17179869184/Mapa-zastavek-salin/schemata/ceska.png

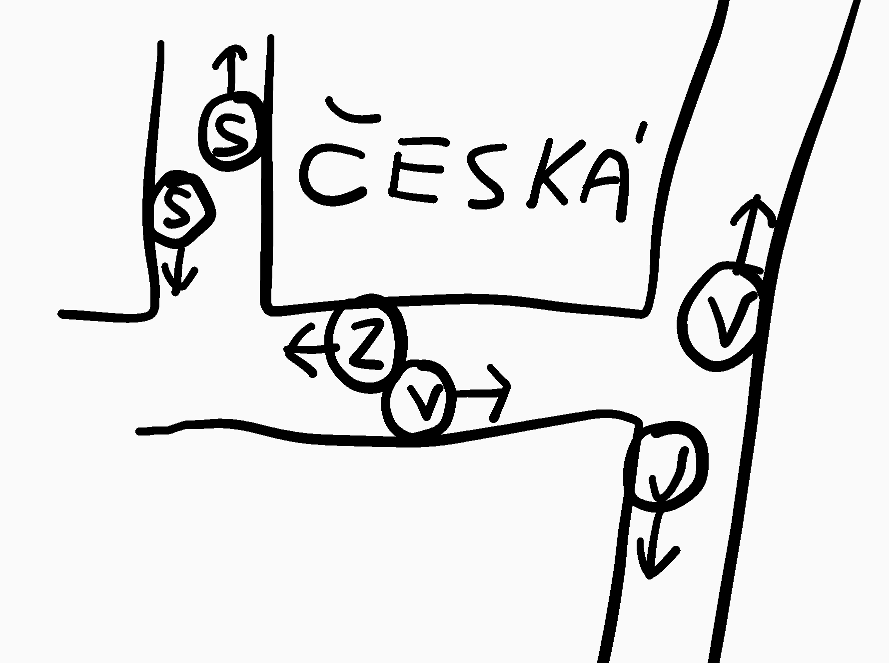
schemata/ceska.png
