17179869184/Mapa-zastavek-salin/schemata/hlavninadrazi.png

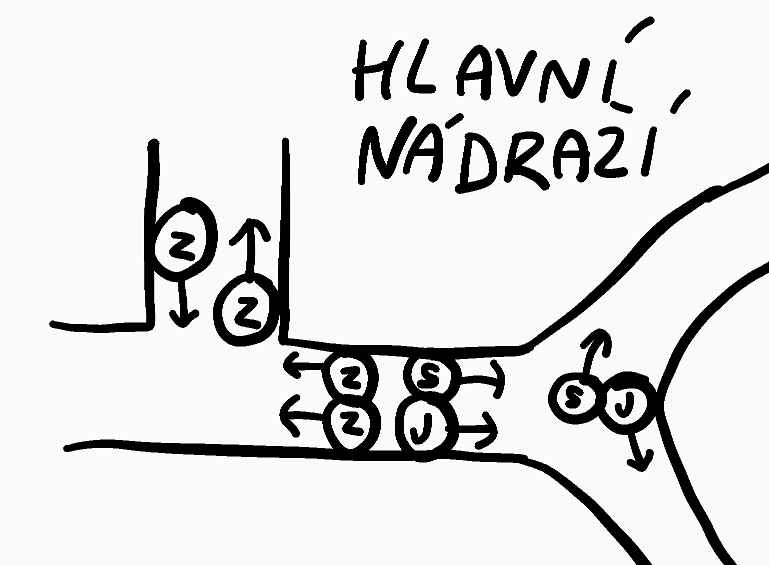
schemata/hlavninadrazi.png
