17179869184/Mapa-zastavek-salin/schemata/jugoslavska.png

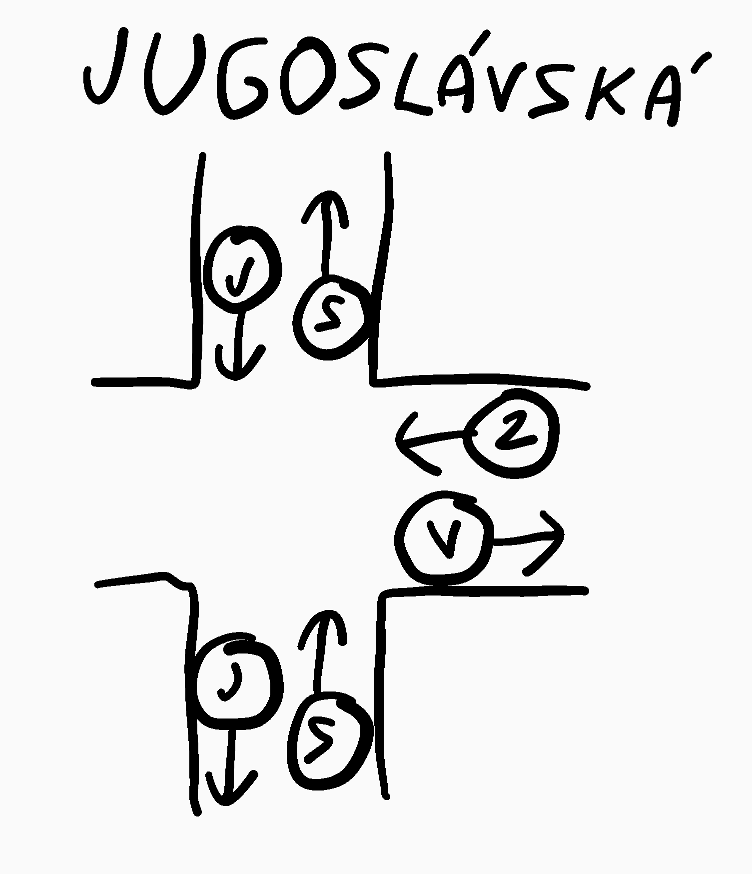
schemata/jugoslavska.png
