17179869184/Mapa-zastavek-salin/schemata/malinovskehonamesti.png

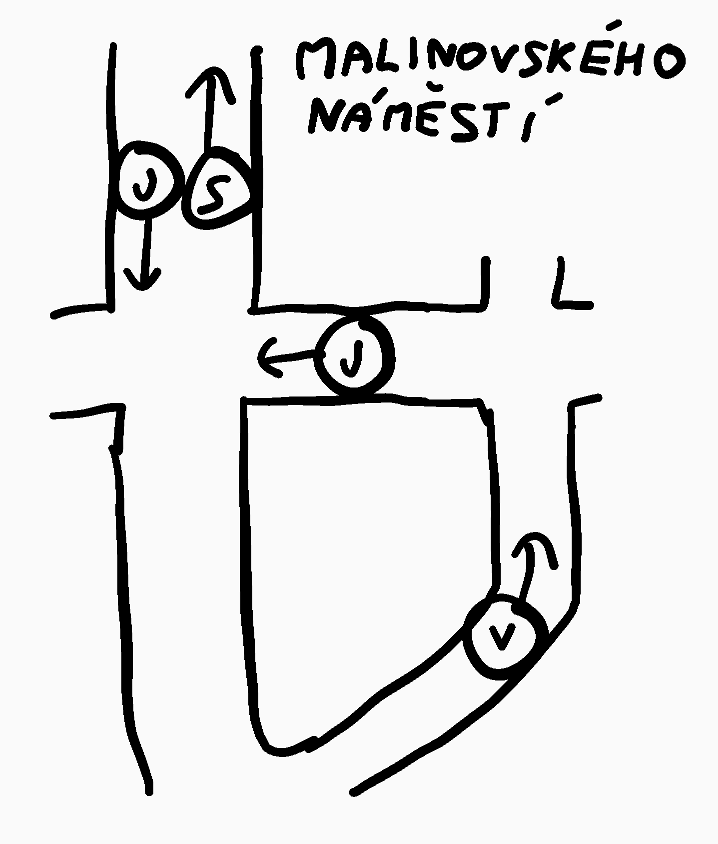
schemata/malinovskehonamesti.png
