17179869184/Mapa-zastavek-salin/schemata/mendlovonamesti.png

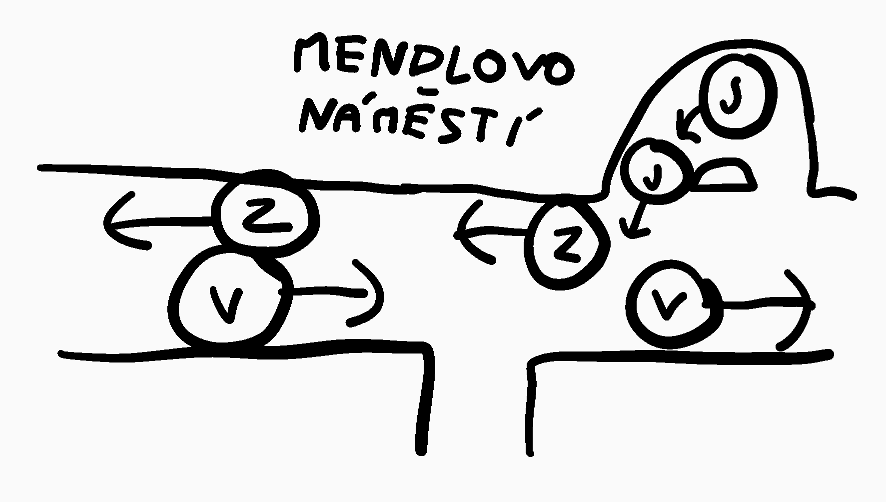
schemata/mendlovonamesti.png
