17179869184/Mapa-zastavek-salin/schemata/moravskenamesti.png

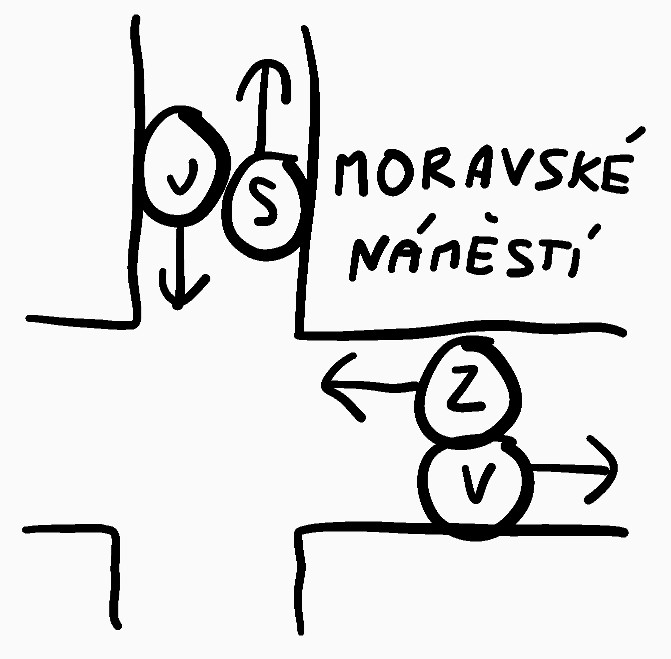
schemata/moravskenamesti.png
