17179869184/Mapa-zastavek-salin/schemata/semilasso.png

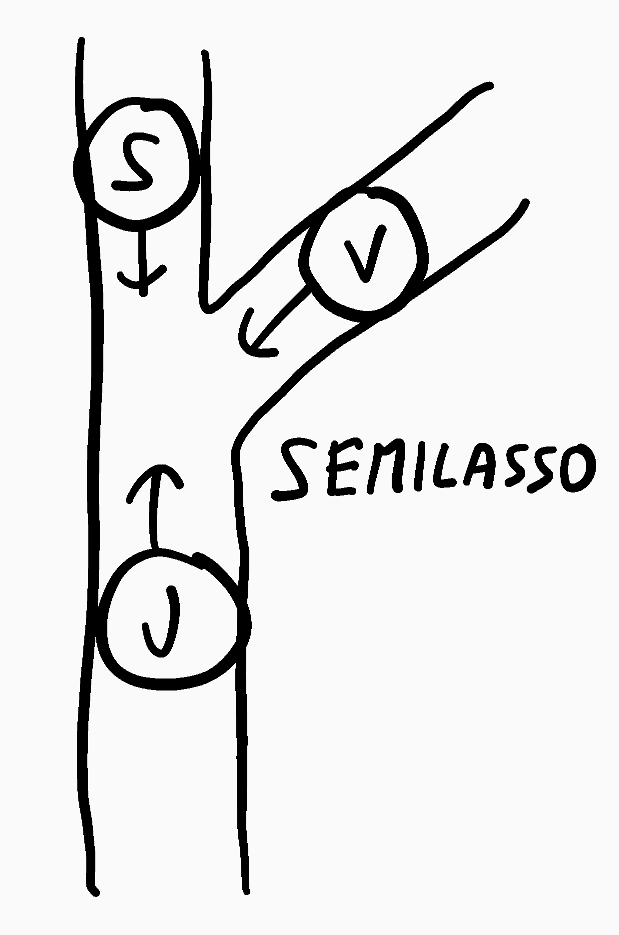
schemata/semilasso.png
