17179869184/Mapa-zastavek-salin/schemata/silingrovonamesti.png

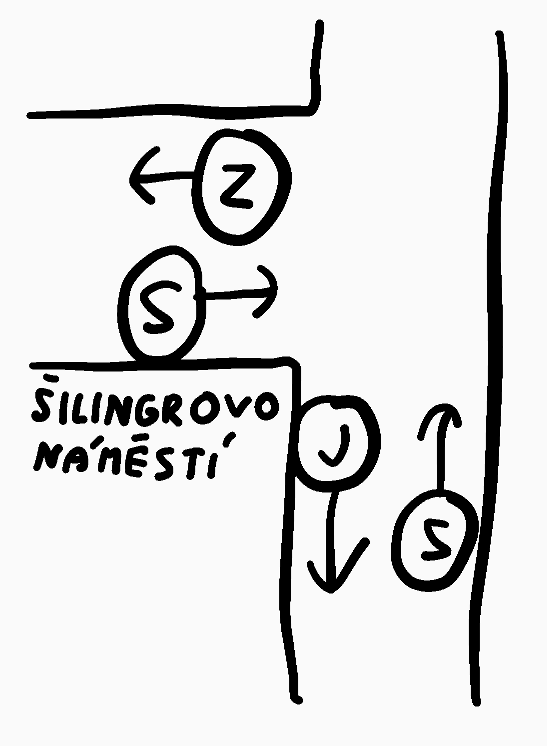
schemata/silingrovonamesti.png
