17179869184/Mapa-zastavek-salin/arduino/zastavky.h

#ifndef ZASTAVKY_H
#define ZASTAVKY_H

#define ANTONINSKA 0
#define AUTOBUSOVE_NADRAZI 1
#define OBRANY_BABICKA 2
#define BELOHORSKA 3
#define BELORUSKA 4
#define BIEBLOVA 5
#define BILA_HORA 6
#define BOHUNICKA 7
#define BRAFOVA 8
#define BRANKA 9
#define BURIANOVO_NAMESTI 10
#define BUZKOVA 11
#define CELNI 12
#define CERTOVA_ROKLE 13
#define CERVINKOVA 14
#define CESKA 15
#define CTVERY_HONY 16
#define DELNICKY_DUM 17
#define DETSKA_NEMOCNICE 18
#define DOBROVSKEHO 19
#define DUNAJSKA 20
#define ECEROVA 21
#define FILKUKOVA 22
#define FUGNEROVA 23
#define GEISLEROVA 24
#define GROHOVA 25
#define HALASOVO_NAMESTI 26
#define HEINRICHOVA 27
#define HLAVNI_NADRAZI 28
#define HLUBOKA 29
#define HRNCIRSKA 30
#define HUDCOVA 31
#define HUSITSKA 32
#define HYBESOVA 33
#define JIROVA 34
#define JUGOSLAVSKA 35
#define JULIANOV 36
#define VOZOVNA_KOMIN 37
#define JUNGMANNOVA 38
#define KAMENOLOM 39
#define KARPATSKA 40
#define KARTOUZSKA 41
#define KLUSACKOVA 42
#define KOMAROV 43
#define KOMENSKEHO_NAMESTI 44
#define KOMIN_SMYCKA 45
#define KONECNEHO_NAMESTI 46
#define KONOPNA 47
#define KORNEROVA 48
#define KORISKOVA 49
#define KOTLANOVA 50
#define KRALOVA 51
#define KRALOVO_POLE_NADRAZI 52
#define KRASNEHO 53
#define KREMATORIUM 54
#define KRIDLOVICKA 55
#define KUBICKOVA 56
#define KULDOVA 57
#define LESNICKA 58
#define ARENA_BRNO 59
#define LISENSKA 60
#define MALINOVSKEHO_NAMESTI 61
#define MALOMERICKY_MOST 62
#define MASAROVA 63
#define NAMESTI_MIRU 64
#define MASNA 65
#define MENDLOVO_NAMESTI 66
#define MIFKOVA 67
#define MODRICKA_CIHELNA 68
#define MORAVANSKA 69
#define MORAVANSKE_LANY 70
#define MORAVSKE_NAMESTI 71
#define MOSTECKA 72
#define MOZOLKY 73
#define NAMESTI_28_RIJNA 74
#define NAMESTI_REPUBLIKY 75
#define NAMESTI_SVOBODY 76
#define NEMOCNICE_U_SVATE_ANNY 77
#define NEMOCNICE_BOHUNICE 78
#define NEMOCNICE_MILOSRDNYCH_BRATRI 79
#define NERUDOVA 80
#define VOZOVNA_HUSOVICE 81
#define NOVE_SADY 82
#define NOVOLISENSKA 83
#define OBILNI_TRH 84
#define OBRANSKA_U_SKOLY 85
#define OBRANSKY_MOST 86
#define ONDROUSKOVA 87
#define ORECHOVSKA 88
#define OSOVA 89
#define OTAKARA_SEVCIKA 90
#define PIONYRSKA 91
#define PISARKY 92
#define PODLESI 93
#define PODSTRANSKA 94
#define PORICI 95
#define PROSKOVO_NAMESTI 96
#define PRISTAVISTE 97
#define RAKOVECKA 98
#define ROSICKEHO_NAMESTI 99
#define RYBKOVA 100
#define RECKOVICE 101
#define SEMILASSO 102
#define SKACELOVA 103
#define SOCHOROVA 104
#define SOUKENICKA 105
#define STARA_OSADA 106
#define STARY_LISKOVEC_SMYCKA 107
#define STRANSKA_SKALA 108
#define STRANSKA_SKALA_SMYCKA 109
#define STRANSKEHO 110
#define SVRATECKA 111
#define SILINGROVO_NAMESTI 112
#define STEFANIKOVA_CTVRT 113
#define SUMAVSKA 114
#define SVERMOVA 115
#define TABOR 116
#define TECHNOLOGICKY_PARK 117
#define TEREROVA 118
#define TKALCOVSKA 119
#define TECHNICKE_MUZEUM 120
#define TOMANOVA 121
#define TOMKOVO_NAMESTI 122
#define TRAVNICKOVA 123
#define TYLOVA 124
#define USTREDNI_HRBITOV 125
#define USTREDNI_HRBITOV_SMYCKA 126
#define UVOZ 127
#define UZKA 128
#define VACLAVSKA 129
#define VENHUDOVA 130
#define VLHKA 131
#define VOJTOVA 132
#define VOZOVNA_MEDLANKY_2 133
#define VSETINSKA 134
#define VSETICKOVA 135
#define VYSTAVISTE_HLAVNI_VSTUP 136
#define VYSTAVISTE_VSTUP_G2 137
#define VOJENSKA_NEMOCNICE 138
#define ZAPADNI_BRANA 139
#define ZDRAHALOVA 140
#define ZELNY_TRH 141
#define ZEMEDELSKA 142
#define ZOOLOGICKA_ZAHRADA 143
#define ZELEZNICNI 144
#define ZIDOVSKY_HRBITOV 145
#define ZIVOTSKEHO 146
#define VOZOVNA_PISARKY 147
#define VOZOVNA_MEDLANKY 148
#define MODRICE_SMYCKA 149
#define MODRICE_TYRSOVA 150

uint16_t najitLedku(uint8_t z, uint8_t s);
uint8_t tlacitkoNaZastavku(uint8_t r, uint8_t c);
uint8_t vZone(uint8_t z);

#endif
